AutoPESystem/AutoPAC/README.md

# AutoPAC
This repository will contain the relevant firmware and hardware for an automated PAC (Pump Assisted Clamping) Device.
