AutoPESystem/AutoPAC/Hardware/PCB/README.md

# PCB
This is a KiCAD PCB project that contains the hardware implementation required for the AutoPAC device.

This includes a vacuum sensor, positive pressure sensor, circuitry to drive 2 brushed motors, circuitry to control multiple solenoid relays, and an LCD interface over SPI.
