AutoPESystem/AutoPAC/Hardware/PCB/buck_reference_layout.png

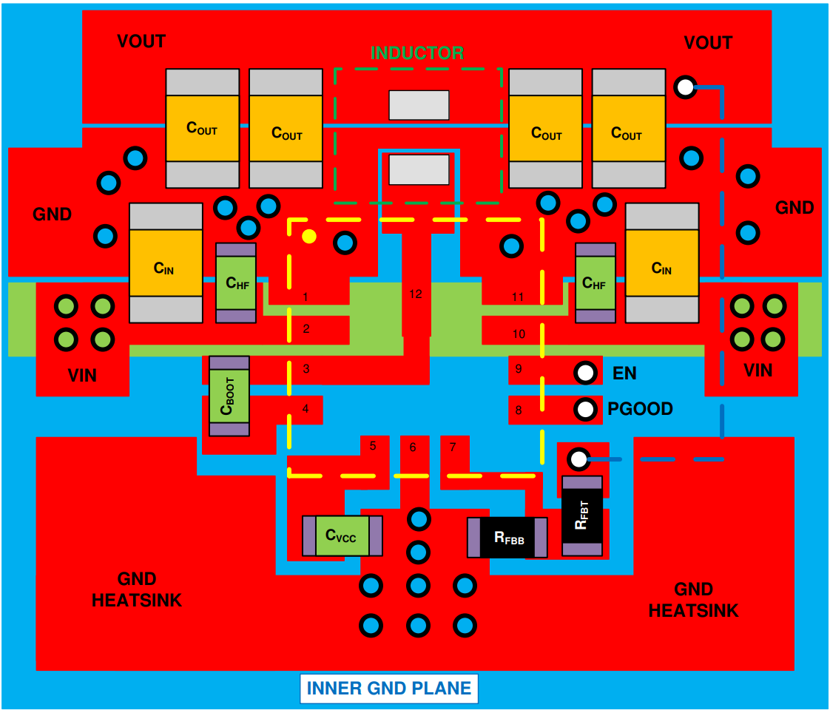
Hardware/PCB/buck_reference_layout.png
