AutoPESystem/AutoPAC/Hardware/PCB/lcd_reference_schematic.png

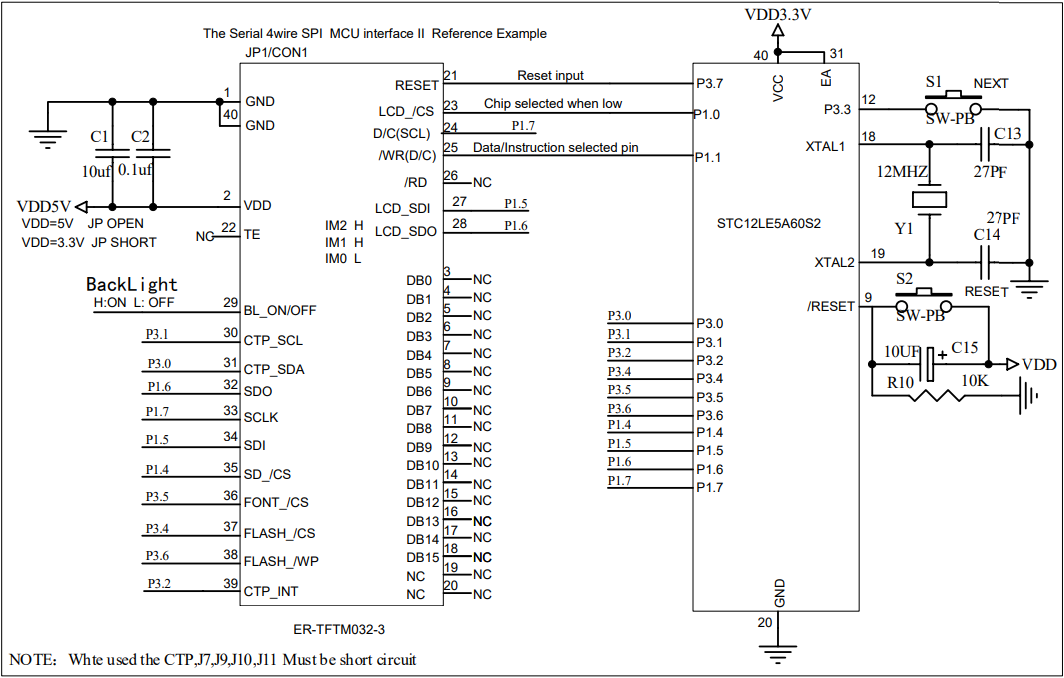
Hardware/PCB/lcd_reference_schematic.png
