AutoPESystem/AutoPAC/Hardware/PCB/suggested_stackup.png

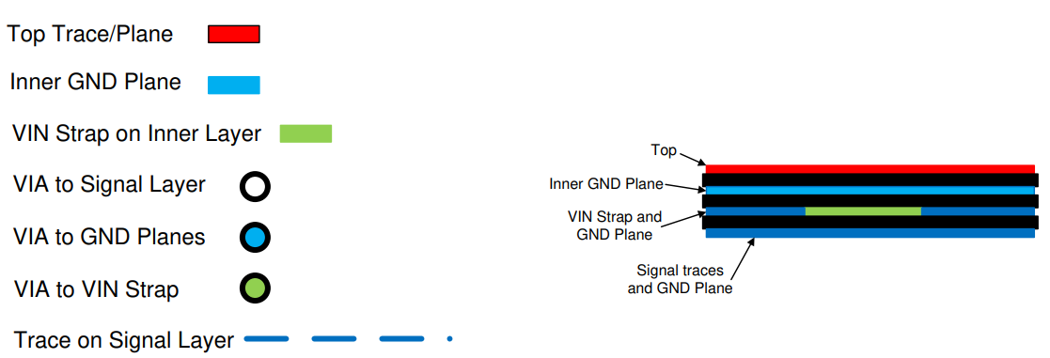
Hardware/PCB/suggested_stackup.png
