AutoPESystem/AutoPAC/Hardware/PCB/Vendor_3D_Models/MPX5500DP.stp

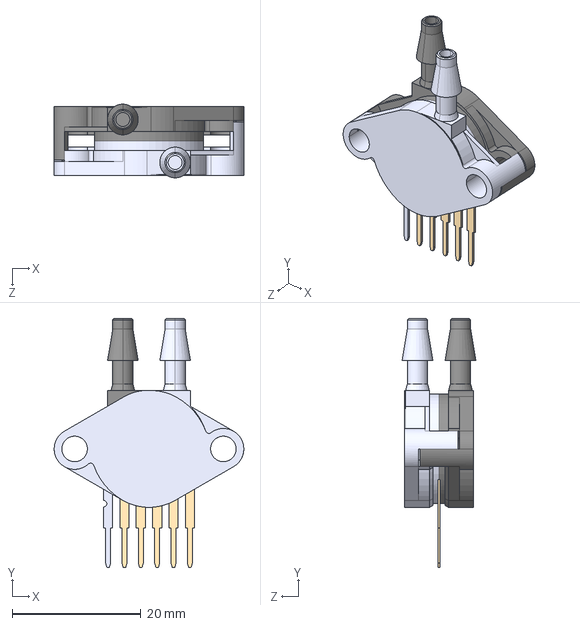
[picture p4: CAD file, 2025-03-04]
Hardware/PCB/Vendor_3D_Models/MPX5500DP.stp
29.5 x 38.7 x 11.5 mm
