AutoPESystem/AutoPAC/Hardware/PCB/Vendor_3D_Models/DTT0008A.stp

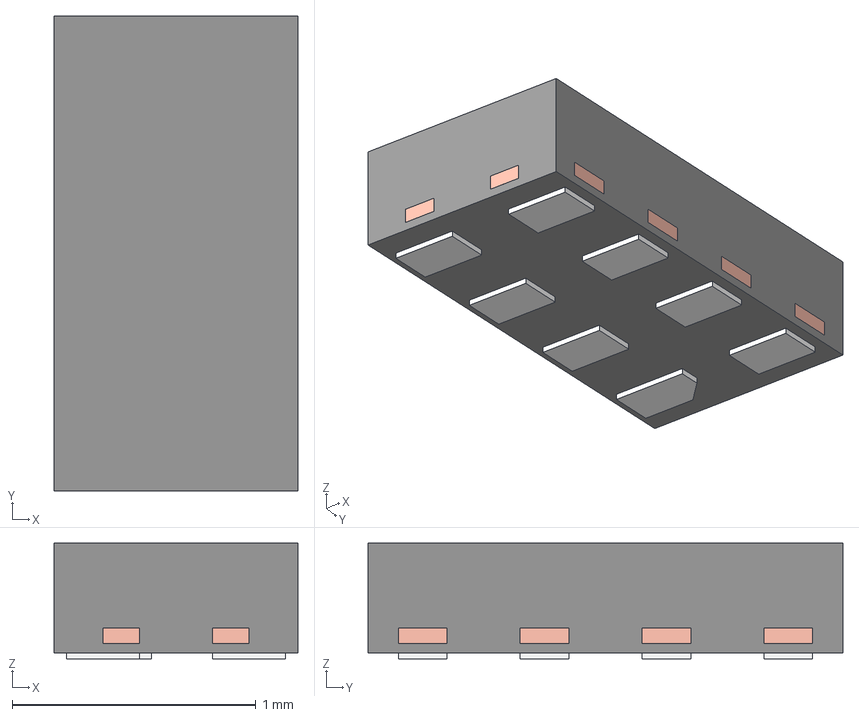
[picture p5: CAD file, 2025-03-02]
Hardware/PCB/Vendor_3D_Models/DTT0008A.stp
1.00 x 1.95 x 0.475 mm
BODY-SON
FRAME-DTT0008A
PIN1-ID
