AutoPESystem/AutoPAC/Hardware/PCB/Vendor_3D_Models/XSON8_SOT833-1_NEX.step

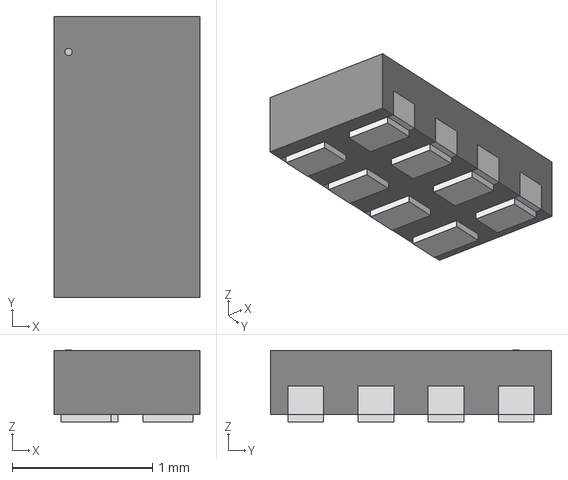
[picture p6: CAD file, 2025-03-02]
Hardware/PCB/Vendor_3D_Models/XSON8_SOT833-1_NEX.step
1.04 x 2.01 x 0.511 mm
