AutoPESystem/AutoPAC/Hardware/PCB/Vendor_3D_Models/TPSM84338RCJR.stp

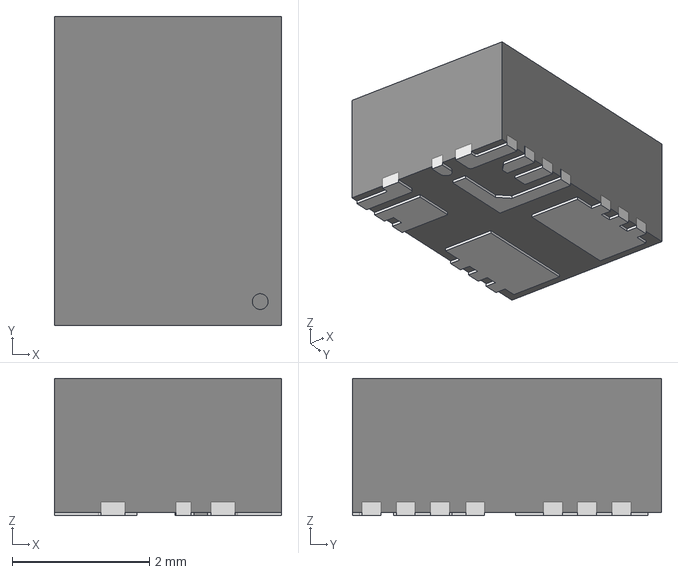
[picture p7: CAD file, 2025-03-02]
Hardware/PCB/Vendor_3D_Models/TPSM84338RCJR.stp
3.30 x 4.50 x 2.00 mm
