AutoPESystem/AutoPAC/Hardware/PCB/Vendor_3D_Models/SRN8040-3R3Y.stp

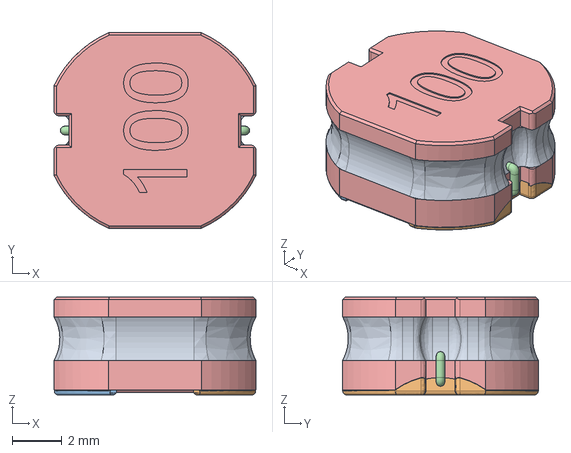
[picture p8: CAD file, 2025-03-02]
Hardware/PCB/Vendor_3D_Models/SRN8040-3R3Y.stp
8.15 x 7.90 x 3.95 mm
