AutoPESystem/AutoPAC/Hardware/PCB/Vendor_3D_Models/PHX_16pin_1985292.stp

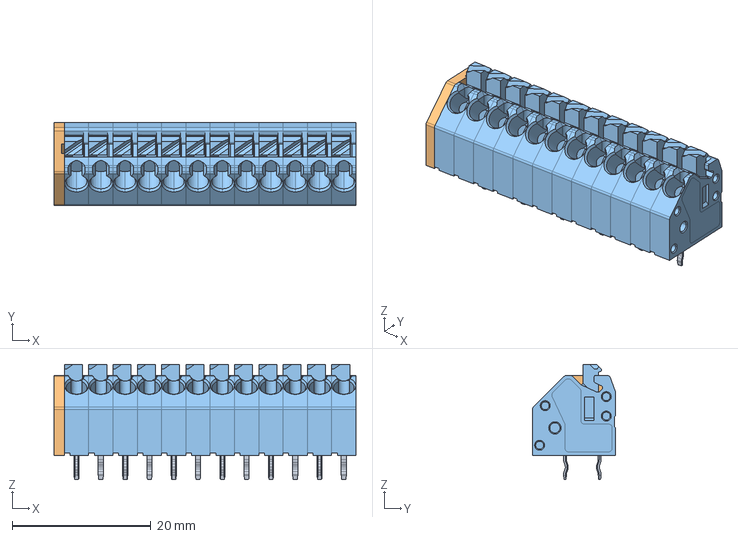
[picture p9: CAD file, 2025-03-02]
Hardware/PCB/Vendor_3D_Models/PHX_16pin_1985292.stp
43.5 x 12.0 x 16.6 mm
