AutoPESystem/AutoPAC/Hardware/PCB/Vendor_3D_Models/LSF0102DQER.step

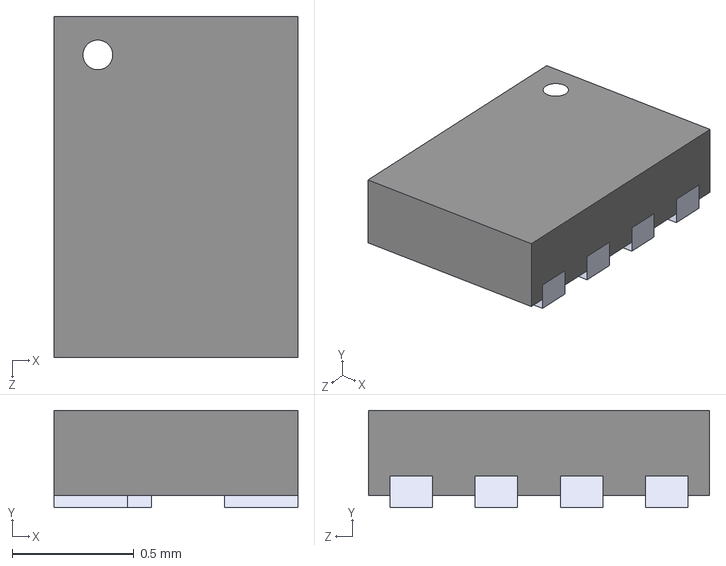
[picture p10: CAD file, 2025-03-02]
Hardware/PCB/Vendor_3D_Models/LSF0102DQER.step
1.00 x 0.4 x 1.40 mm
