AutoPESystem/AutoPAC/Hardware/PCB/Vendor_3D_Models/PJ-102A.step

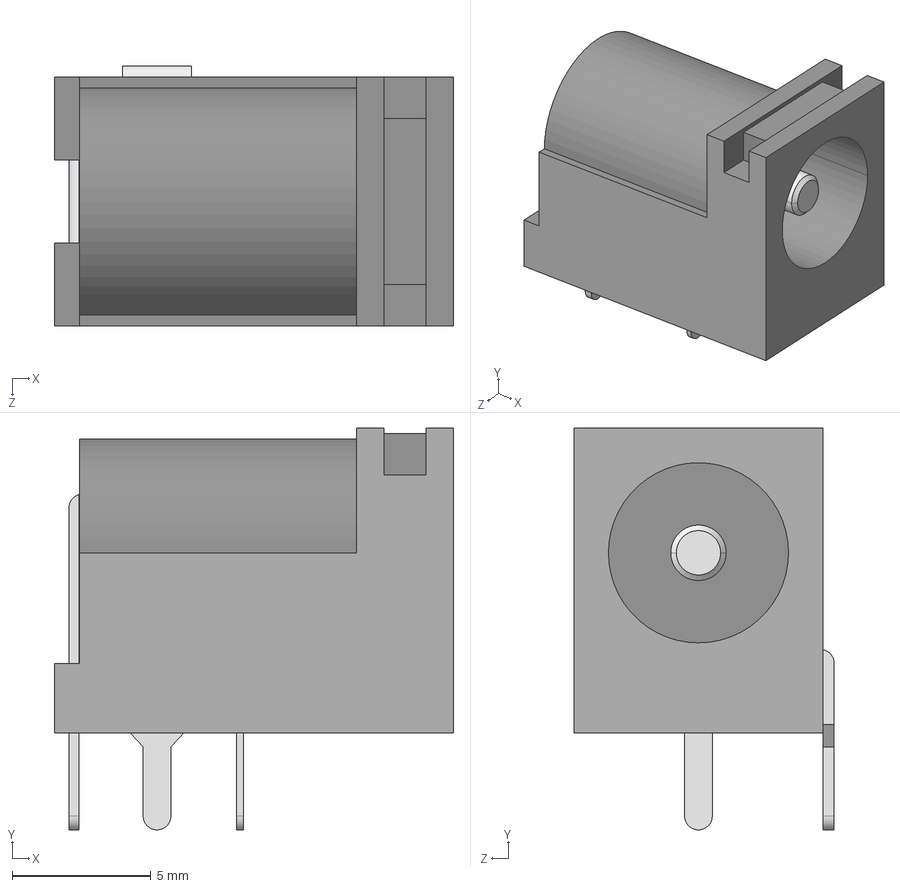
[picture p11: CAD file, 2025-02-24]
Hardware/PCB/Vendor_3D_Models/PJ-102A.step
14.4 x 14.5 x 9.40 mm
