AutoPESystem/AutoPAC/Hardware/PCB/Vendor_3D_Models/54-00127.step

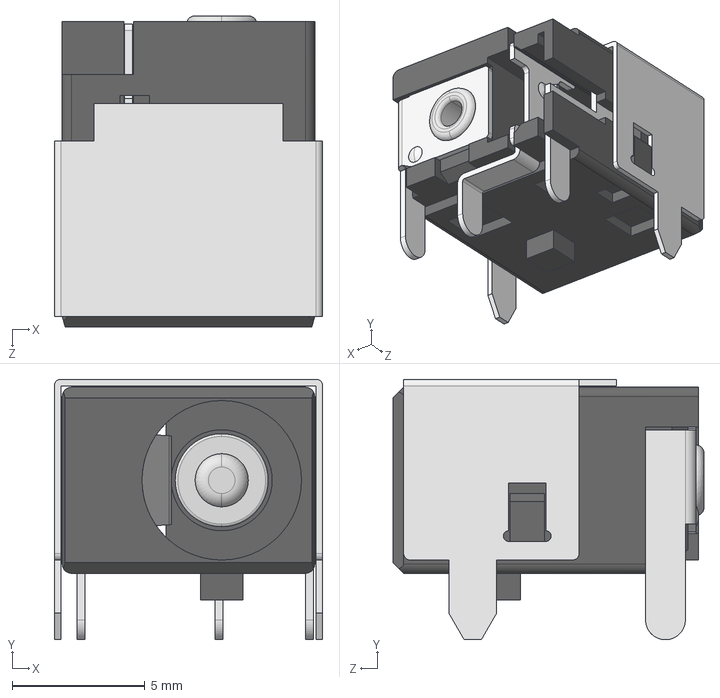
[picture p12: CAD file, 2025-02-24]
Hardware/PCB/Vendor_3D_Models/54-00127.step
10.1 x 9.80 x 11.7 mm
