AutoPESystem/AutoPAC/Hardware/PCB/Vendor_3D_Models/RNX0012A.stp

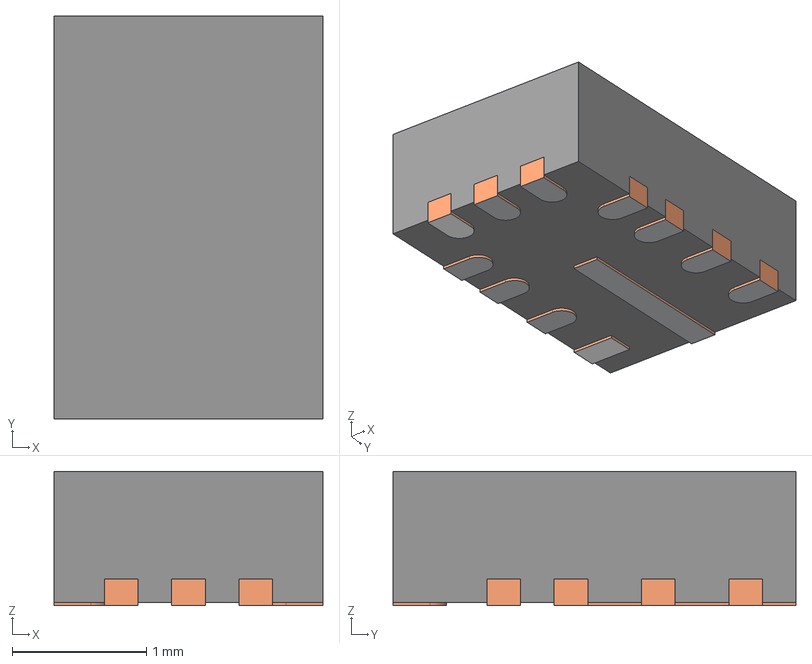
[picture p13: CAD file, 2025-02-24]
Hardware/PCB/Vendor_3D_Models/RNX0012A.stp
2.00 x 3.00 x 1.00 mm
FRAME-RNX0012A
BODY-QFN
PIN1-ID
