AutoPESystem/AutoPAC/Hardware/PCB/Vendor_3D_Models/FFC3B07-40-T.step

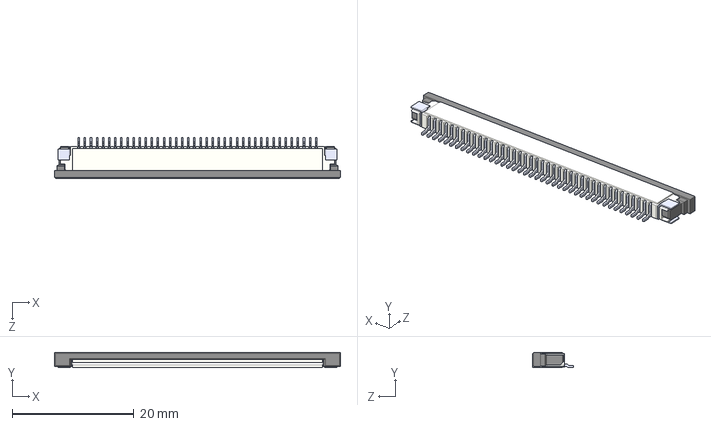
[picture p14: CAD file, 2025-02-21]
Hardware/PCB/Vendor_3D_Models/FFC3B07-40-T.step
47.0 x 2.50 x 6.75 mm
FFC3B07-xxxx_40
pin^FFC3B07-xxxx ass x 40
