AutoPESystem/AutoPAC/Hardware/PCB/Vendor_3D_Models/PTS647SN50SMTR2LFS.stp

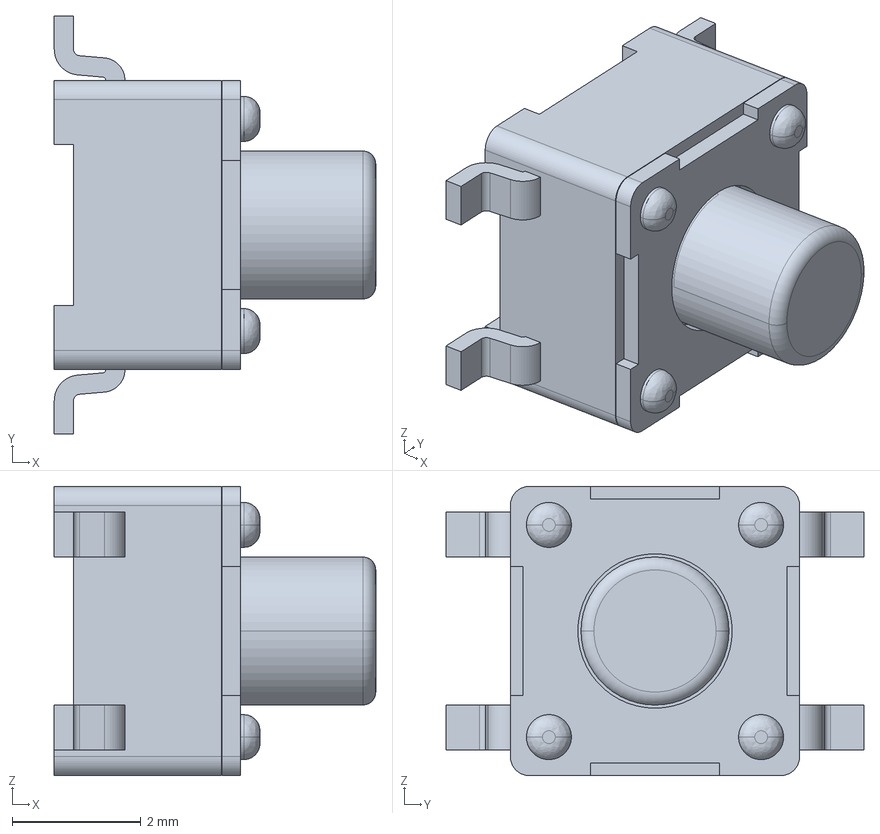
[picture p15: CAD file, 2025-02-21]
Hardware/PCB/Vendor_3D_Models/PTS647SN50SMTR2LFS.stp
5.00 x 6.50 x 4.50 mm
