AutoPESystem/AutoPAC/Hardware/PCB/Vendor_3D_Models/112C-TBAR-R02 v1.step

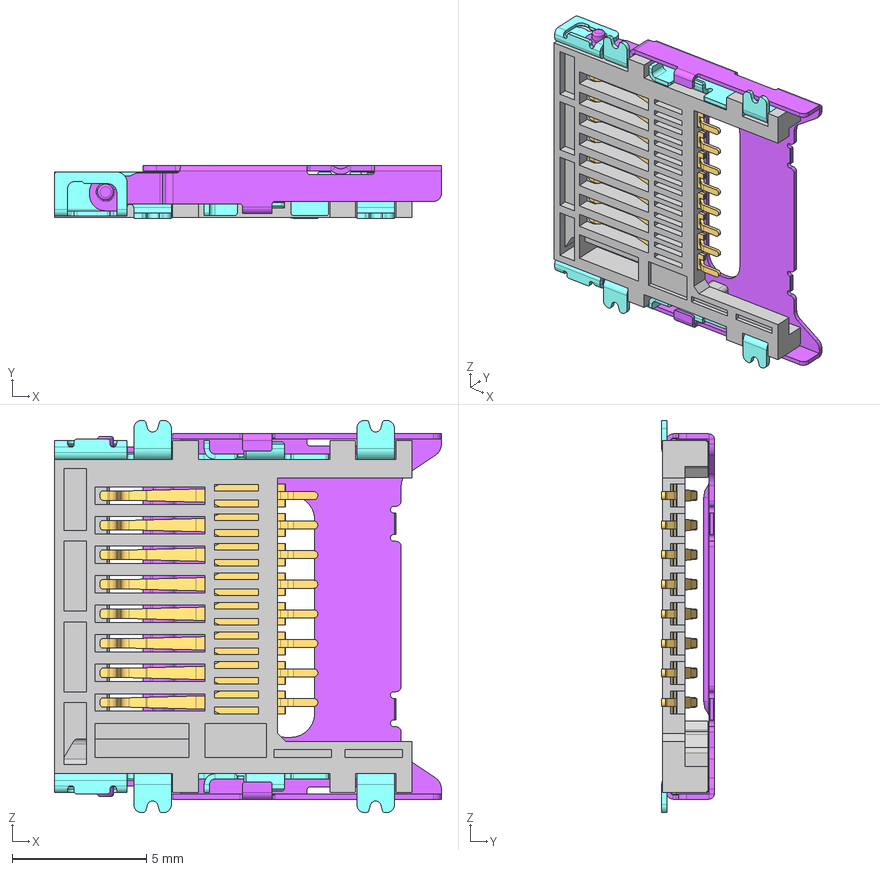
[picture p16: CAD file, 2025-02-21]
Hardware/PCB/Vendor_3D_Models/112C-TBAR-R02 v1.step
14.4 x 1.96 x 14.6 mm
