AutoPESystem/AutoPAC/Hardware/PCB/Vendor_3D_Models/c-1-2834011-2-2-3d.stp

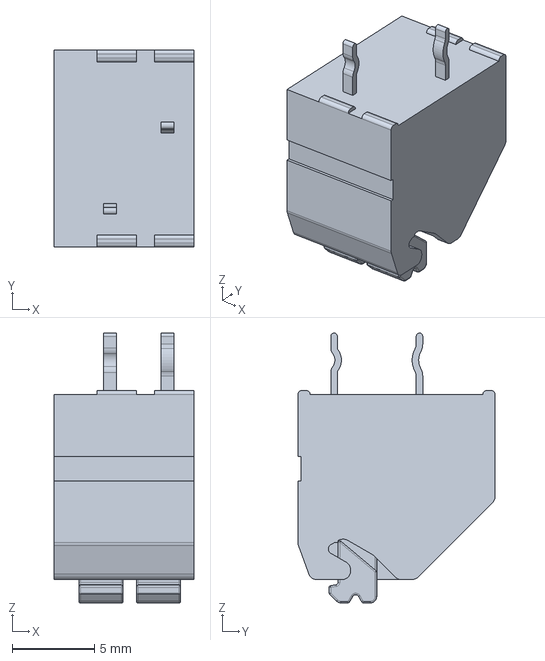
[picture p17: CAD file, 2025-02-21]
Hardware/PCB/Vendor_3D_Models/c-1-2834011-2-2-3d.stp
8.50 x 12.0 x 16.4 mm
