AutoPESystem/AutoPAC/Hardware/PCB/Vendor_3D_Models/1056.step

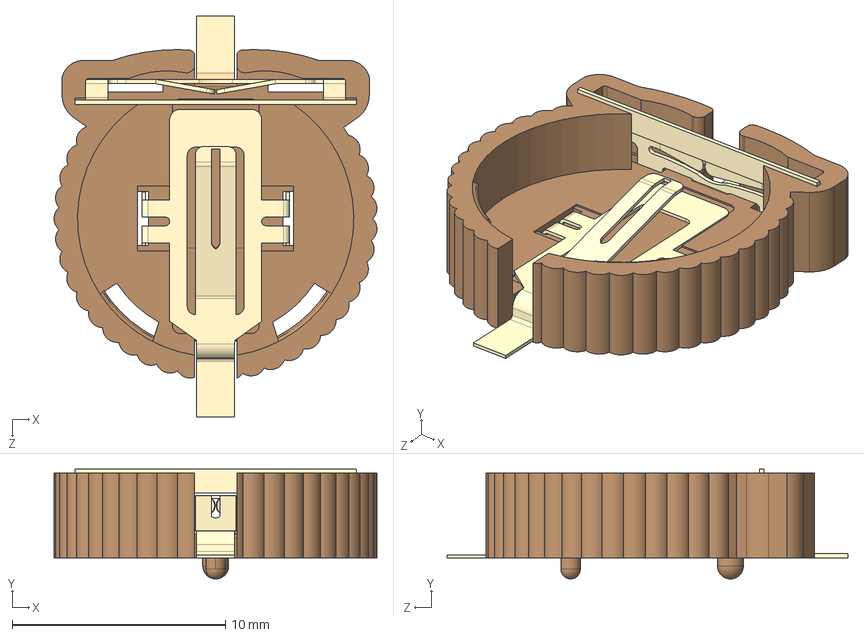
[picture p18: CAD file, 2025-02-21]
Hardware/PCB/Vendor_3D_Models/1056.step
15.1 x 5.16 x 18.8 mm
