AutoPESystem/AutoPAC/Hardware/PCB/Vendor_3D_Models/c-1-2834011-3-2-3d.stp

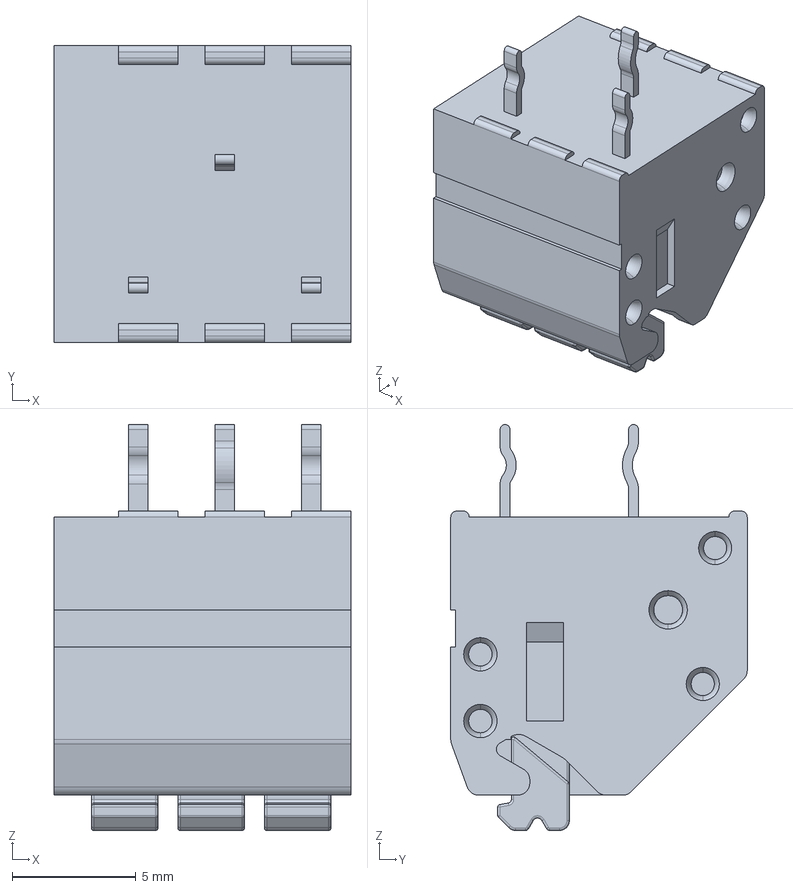
[picture p19: CAD file, 2025-02-21]
Hardware/PCB/Vendor_3D_Models/c-1-2834011-3-2-3d.stp
12.0 x 12.0 x 16.4 mm
