AutoPESystem/AutoPAC/Hardware/PCB/Vendor_3D_Models/ESP32-S3-WROOM-1U-N16R8.step

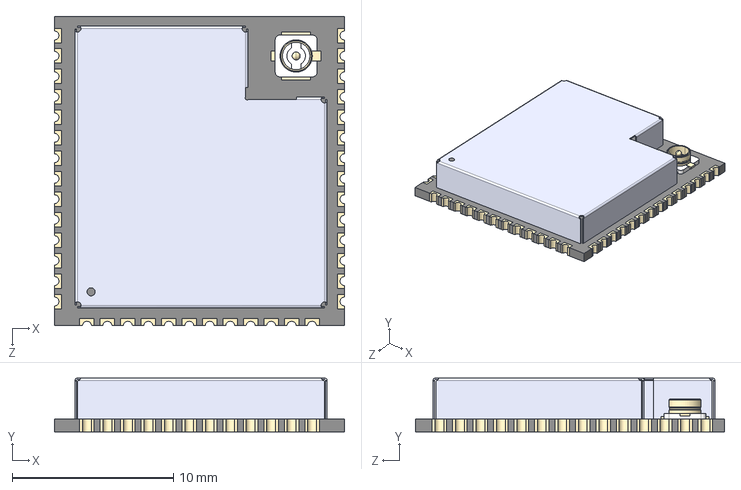
[picture p20: CAD file, 2025-02-21]
Hardware/PCB/Vendor_3D_Models/ESP32-S3-WROOM-1U-N16R8.step
18.0 x 3.35 x 19.2 mm
