AutoPESystem/AutoPAC/Hardware/PCB/Vendor_3D_Models/SX1509BIULTRT.step

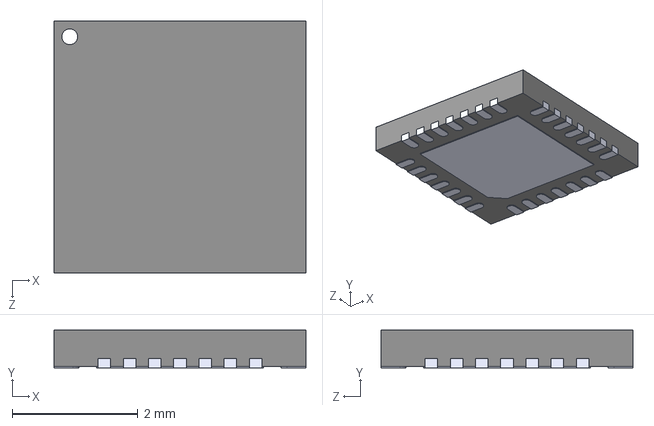
[picture p21: CAD file, 2025-02-21]
Hardware/PCB/Vendor_3D_Models/SX1509BIULTRT.step
4.00 x 0.6 x 4.00 mm
