AutoPESystem/AutoPAC/Hardware/PCB/Vendor_3D_Models/QFN20_4x4MC_MCH.step

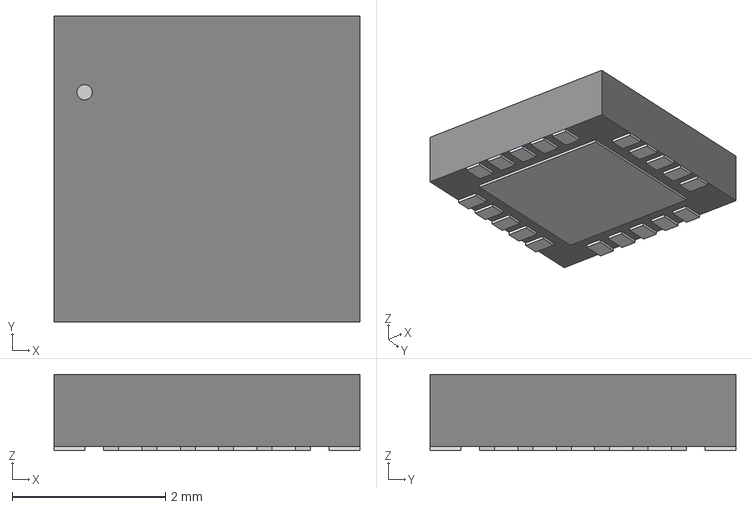
[picture p22: CAD file, 2025-02-21]
Hardware/PCB/Vendor_3D_Models/QFN20_4x4MC_MCH.step
3.99 x 3.99 x 0.993 mm
