AutoPESystem/AutoPAC/Hardware/PCB/Vendor_3D_Models/USB3160-XX-XXXX-X-X_REVA.step

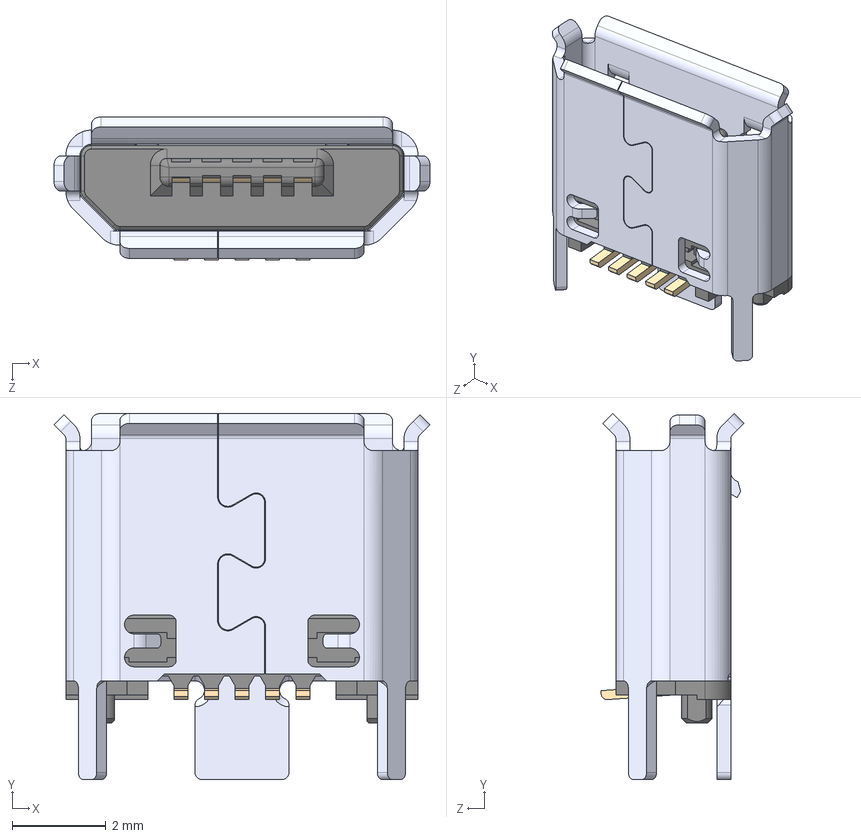
[picture p23: CAD file, 2025-02-21]
Hardware/PCB/Vendor_3D_Models/USB3160-XX-XXXX-X-X_REVA.step
8.00 x 7.79 x 3.04 mm
Housing.step
shell_With Entry face,shell stake =1.60mm.step
