AutoPESystem/AutoPAC/Hardware/PCB/Vendor_3D_Models/BU2032SM-BT-GTR.step

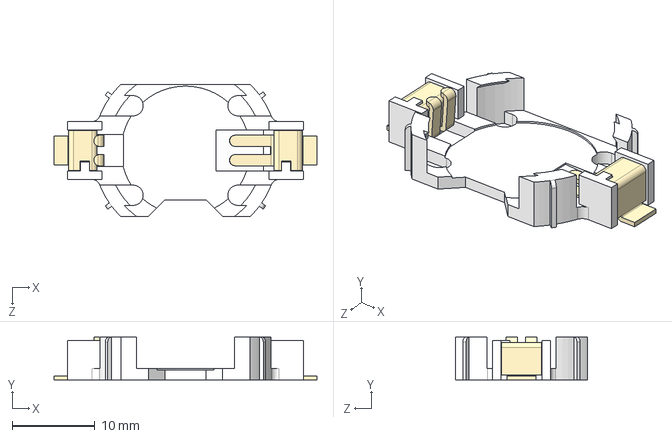
[picture p24: CAD file, 2025-02-21]
Hardware/PCB/Vendor_3D_Models/BU2032SM-BT-GTR.step
31.9 x 5.20 x 16.0 mm
