AutoPESystem/AutoPAC/Hardware/PCB/Vendor_3D_Models/6120XX21621_61201021621.step

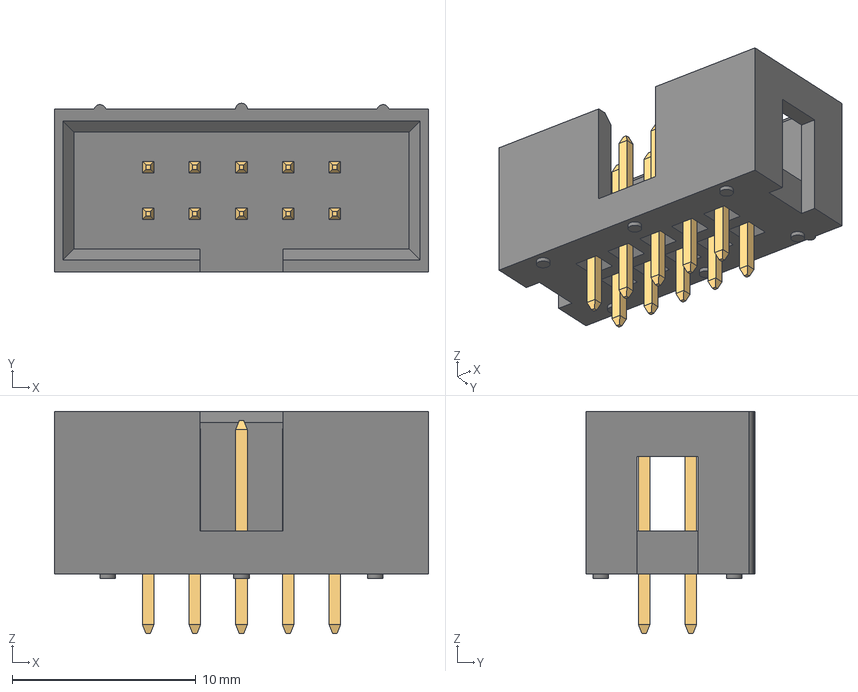
[picture p25: CAD file, 2025-02-21]
Hardware/PCB/Vendor_3D_Models/6120XX21621_61201021621.step
20.4 x 9.18 x 12.1 mm
6120xx21621_PIN x 10
