AutoPESystem/AutoPAC/Hardware/PCB/Vendor_3D_Models/PEC11R-4220K-S0024.STEP

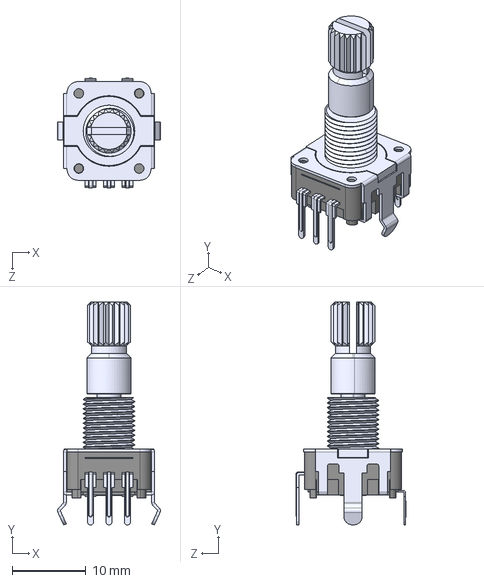
[picture p27: CAD file, 2025-02-21]
Hardware/PCB/Vendor_3D_Models/PEC11R-4220K-S0024.STEP
14.0 x 30.3 x 14.9 mm
