AutoPESystem/AutoPAC/Hardware/PCB/Vendor_3D_Models/MPXV6115VC6U.stp

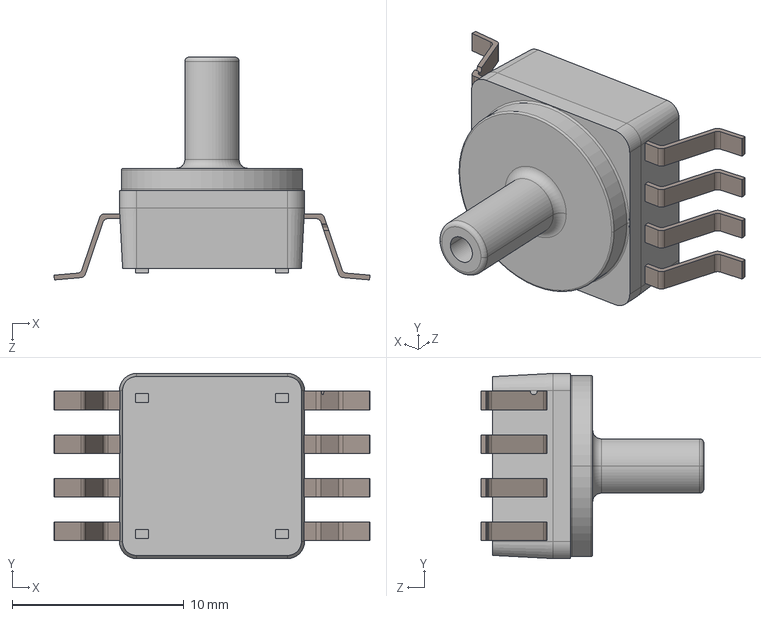
[picture p28: CAD file, 2025-02-21]
Hardware/PCB/Vendor_3D_Models/MPXV6115VC6U.stp
18.4 x 10.8 x 13.0 mm
