AutoPESystem/AutoPAC/Hardware/PCB/Vendor_3D_Models/MPX5100GP.stp

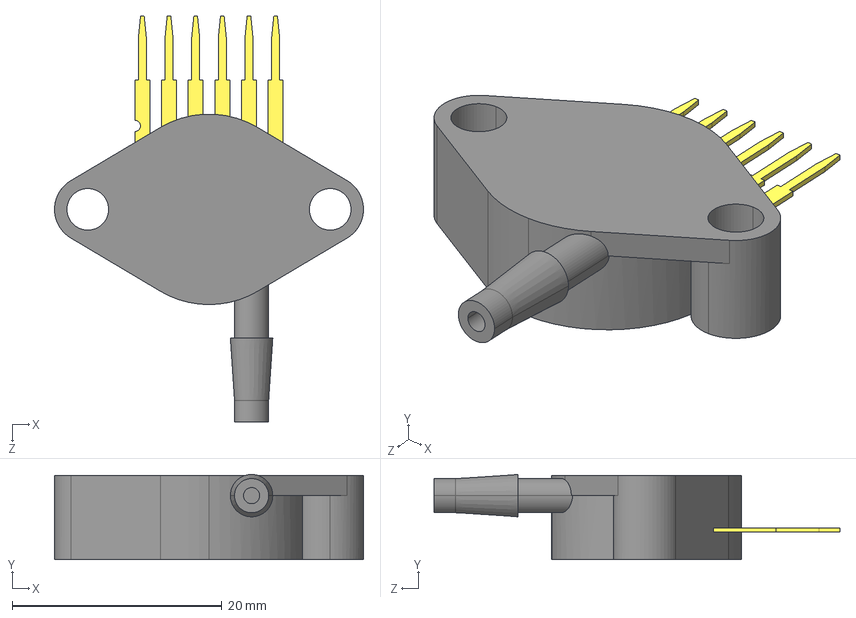
[picture p29: CAD file, 2025-02-21]
Hardware/PCB/Vendor_3D_Models/MPX5100GP.stp
29.5 x 8.12 x 38.7 mm
top
pins
