AutoPESystem/AutoPAC/Hardware/PCB/Vendor_3D_Models/ADS1219IPWR.step

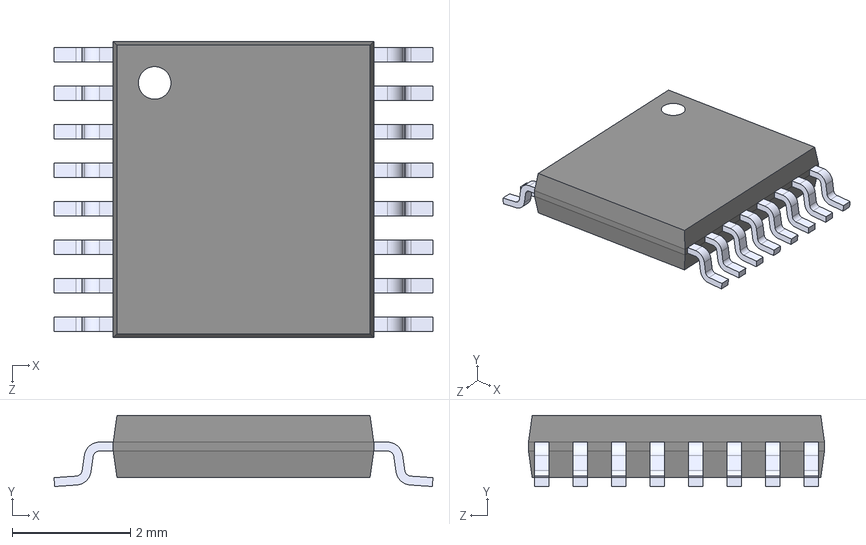
[picture p30: CAD file, 2025-02-21]
Hardware/PCB/Vendor_3D_Models/ADS1219IPWR.step
6.40 x 1.20 x 5.00 mm
