AutoPESystem/AutoPAC/Hardware/PCB/Vendor_3D_Models/DRV8243HQRXYRQ1.stp

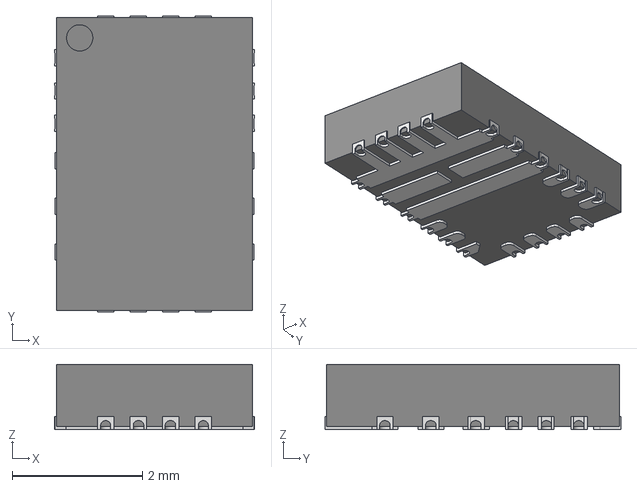
[picture p31: CAD file, 2025-02-21]
Hardware/PCB/Vendor_3D_Models/DRV8243HQRXYRQ1.stp
3.07 x 4.54 x 1.00 mm
