AutoPESystem/AutoPAC/(list of files, cad)

Other CAD files:
Hardware/PCB/Vendor_3D_Models/1984963.stp
Hardware/PCB/Vendor_3D_Models/1985195.stp
Hardware/PCB/Vendor_3D_Models/1985205.step
Hardware/PCB/Vendor_3D_Models/1985218.step
Hardware/PCB/Vendor_3D_Models/473092651.stp
Hardware/PCB/Vendor_3D_Models/541324062.stp
