AutoPESystem/AutoPAC/Hardware/PCB/PCB.kicad_pcb

## KiCad design Hardware/PCB/PCB.kicad_pcb (2025-03-04)

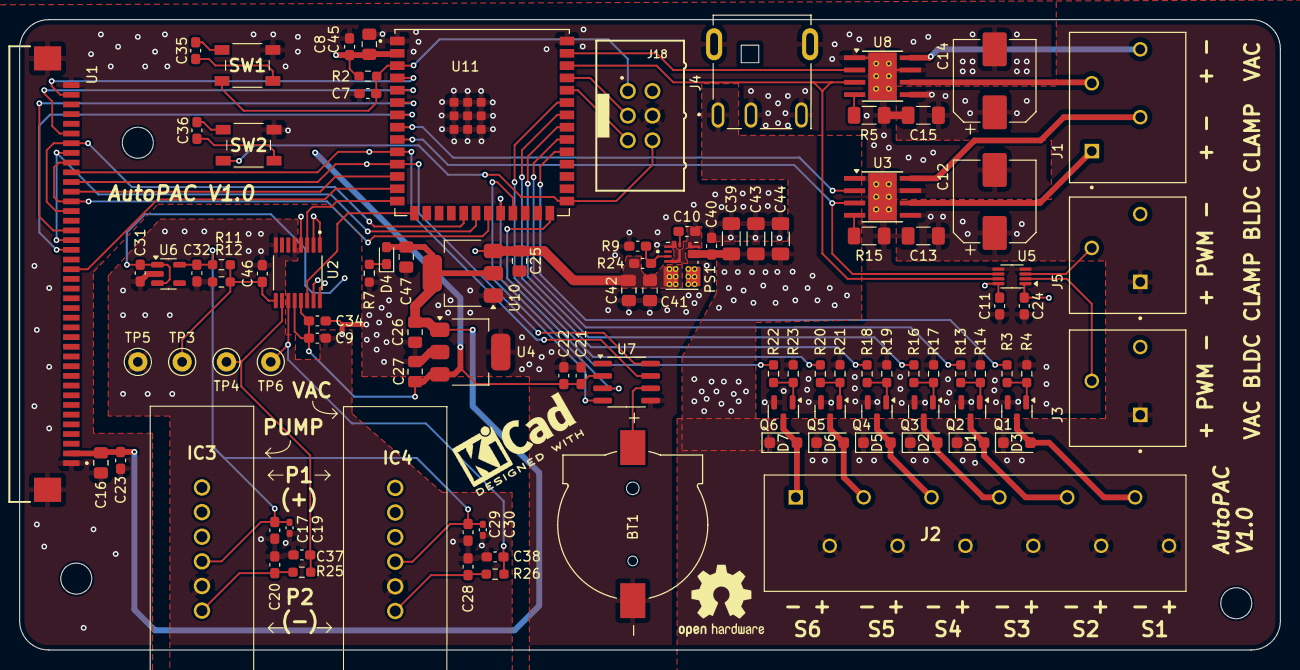
[picture p32: board PCB.kicad_pcb from above]

Board: 4 copper layers, 130.0 x 65.0 mm, 104 parts (0 on the bottom side), 69 nets.

Parts:
BT1: 1056; BAT_1056
C7: 1u; C_0603_1608Metric_Pad1.08x0.95mm_HandSolder
C8, C9, C10, C11, C24, C34, C35, C36, C46: 0.1u; C_0603_1608Metric_Pad1.08x0.95mm_HandSolder
C12, C14: 22uF; CP_Elec_8x10
C13, C15: 0.1uF; C_1206_3216Metric_Pad1.33x1.80mm_HandSolder
C16, C25, C26, C27: 10u; C_0805_2012Metric_Pad1.18x1.45mm_HandSolder
C17, C21, C29, C31, C32: 1uF; C_0603_1608Metric_Pad1.08x0.95mm_HandSolder
C19, C30: 0.01uF; C_0402_1005Metric_Pad0.74x0.62mm_HandSolder
C20, C28: 470pF; C_0603_1608Metric_Pad1.08x0.95mm_HandSolder
C22, C23, C40: 0.1uF; C_0603_1608Metric_Pad1.08x0.95mm_HandSolder
C37, C38: 0.33uF; C_0603_1608Metric_Pad1.08x0.95mm_HandSolder
C39, C43, C44: 10uF; C_1206_3216Metric_Pad1.33x1.80mm_HandSolder
C41, C42, C45, C47: 22uF; C_0805_2012Metric_Pad1.18x1.45mm_HandSolder
D1, D2, D3, D5, D6, D7: SMD110PL-TP; D_SOD-123F
D4: LED; LED_0603_1608Metric_Pad1.05x0.95mm_HandSolder
H1, H3, H4: MountingHole; MountingHole_3.2mm_M3
IC3, IC4: MPX5500DP
J1: DC Motor Terminal; TE_1985218
J2: Solenoid Terminal; PHX_16PIN_1985292
J3: Brushless Vac Motor; TE_1985205
J4: 54-00127; TENSILITY_54-00127
J5: Brushless Pump Motor; TE_1985205
J18: Programmer; 61200621621
NT1: NetTie_2; NetTie-2_SMD_Pad0.5mm
PS1: TPSM84338RCJR; CONV_TPSM84338RCJR
Q1, Q2, Q3, Q4, Q5, Q6: MMBT2222A; SOT-23
R2, R4, R14, R17, R19, R21, R23: 10k; R_0603_1608Metric_Pad0.98x0.95mm_HandSolder
R3, R7, R13, R16, R18, R20, R22: 470; R_0603_1608Metric_Pad0.98x0.95mm_HandSolder
R5, R15: 18k; R_1206_3216Metric_Pad1.30x1.75mm_HandSolder
R9: 10k; C_0603_1608Metric_Pad1.08x0.95mm_HandSolder
R11: 300; R_0603_1608Metric_Pad0.98x0.95mm_HandSolder
R12: 4.7k; R_0603_1608Metric_Pad0.98x0.95mm_HandSolder
R24: 82k; C_0603_1608Metric_Pad1.08x0.95mm_HandSolder
R25, R26: 750; R_0603_1608Metric_Pad0.98x0.95mm_HandSolder
SW1, SW2: PTS647SN50SMTR2LFS
TP3, TP4, TP5, TP6: TestPoint_Probe; TestPoint_Keystone_5000-5004_Miniature
U1: ER-TFTM032-3; GCT_FFC3B07-40-T
U2: ADS1219IPWR; SOP65P640X120-16N
U3, U8: DRV8871DDA; Texas_HTSOP-8-1EP_3.9x4.9mm_P1.27mm_EP2.95x4.9mm_Mask2.4x3.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
U4: AP7361C-33E; SOT-223-3_TabPin2
U5: 74LVC2T45DC; VSSOP-8_2.3x2mm_P0.5mm
U6: TPS7A2050PDBVR; SOT-23-5
U7: DS3232M; SOIC-8_3.9x4.9mm_P1.27mm
U10: AZ1117-5.0; SOT-223-3_TabPin2
U11: ESP32-S3-WROOM-1U-N16R8; XCVR_ESP32-S3-WROOM-1U-N16R8

Connections:
+3.3V: C8.2, C9.2, C11.1, C21.1, C22.2, C27.1, C34.2, C45.2, R2.1, U2.12 (AVDD), U2.13 (DVDD), U4.3 (VO), U5.8 (VCCB), U7.2 (VCC), U11.2 (3V3)
+4.7V: C46.1, R11.2, R12.1, TP3.1, U2.9 (REFP)
+5.5V: C25.1, C31.2, C41.1, C42.1, PS1.4 (VOUT), R24.1, U6.1 (IN), U6.3 (EN), U10.3 (VI)
+5V: C16.2, C23.2, C24.1, C26.1, C47.1, D4.2 (A), U1.2 (VDD), U4.1 (VI), U5.1 (VCCA), U10.2 (VO)
+5VA: C17.1, C19.1, C29.1, C30.1, C32.2, IC3.3 (VCC), IC4.3 (VCC), R11.1, U6.5 (OUT)
+24V: C12.1, C13.1, C14.1, C15.1, C39.1, C40.2, C43.1, C44.1, D1.1 (K), D2.1 (K), D3.1 (K), D5.1 (K), D6.1 (K), D7.1 (K), J2.2, J2.4, J2.6, J2.8, J2.10, J2.12, J3.1, J4.A, J5.1, PS1.6 (VIN), U3.5 (VM), U8.5 (VM)
/ADC-DRDY: U2.14 (~DRDY), U11.15 (IO3)
/ADC-RESET: U2.3 (~RESET), U11.14 (IO20)
/CTP-INT: U1.39 (CTP_INT), U11.4 (IO4)
/DISP-BACKLIGHT: U1.29 (BL_ON/OFF), U11.12 (IO8)
/DISP-CS: U1.23 (LCD_CS), U11.7 (IO7)
/DISP-DC: U1.25 (/WR(D/C)), U11.6 (IO6)
/DISP-RESET: U1.21 (RESET), U11.13 (IO19)
/ESP32-S3/BOOT: J18.6, SW2.1, U11.27 (IO0)
/ESP32-S3/EN: C7.2, J18.1, R2.2, SW1.1, U11.3 (EN)
/ESP32-S3/RX: J18.5, U11.36 (RXD0)
/ESP32-S3/TX: J18.3, U11.37 (TXD0)
/I2C-SCL: U1.30 (CTP_SCL), U2.16 (SCL), U7.8 (SCL), U11.11 (IO18)
/I2C-SDA: U1.31 (CTP_SDA), U2.15 (SDA), U7.7 (SDA), U11.10 (IO17)
/PUMP-IN1: U3.3 (IN1), U5.6 (2B), U11.9 (IO16)
/PUMP-IN2: U3.2 (IN2), U11.8 (IO15)
/RTC-INT: U7.3 (~INT/SQW), U11.22 (IO14)
/RTC-RESET: U7.4 (~RST), U11.23 (IO21)
/SOLENOID_1: R3.1, U11.31 (IO38)
/SOLENOID_2: R13.1, U11.32 (IO39)
/SOLENOID_3: R16.1, U11.33 (IO40)
/SOLENOID_4: R18.1, U11.34 (IO41)
/SOLENOID_5: R20.1, U11.35 (IO42)
/SOLENOID_6: R22.1, U11.26 (IO45)
/SPI-CLK: U1.24 (D/C(SCL)), U1.33 (SCLK), U11.20 (IO12)
/SPI-MISO: U1.28 (LCD_SDO), U1.32 (SDO), U11.21 (IO13)
/SPI-MOSI: U1.27 (LCD_SDI), U1.34 (SDI), U11.19 (IO11)
/VAC-IN1: U5.7 (1B), U8.3 (IN1), U11.38 (IO2)
/VAC-IN2: U8.2 (IN2), U11.39 (IO1)
/brushless_motor_pwm_driver/BRUSHLESS_PWM_1: J3.2, U5.2 (1A)
/brushless_motor_pwm_driver/BRUSHLESS_PWM_2: J5.2, U5.3 (2A)
/motor_driver1/MOTOR-OUT-1: J1.1, U3.6 (OUT1)
/motor_driver1/MOTOR-OUT-2: J1.2, U3.8 (OUT2)
/motor_driver/MOTOR-OUT-1: J1.3, U8.6 (OUT1)
/motor_driver/MOTOR-OUT-2: J1.4, U8.8 (OUT2)
/relay_driver1/COIL-: D1.2 (A), J2.9, Q2.3 (C)
/relay_driver2/COIL-: D2.2 (A), J2.7, Q3.3 (C)
/relay_driver3/COIL-: D5.2 (A), J2.5, Q4.3 (C)
/relay_driver4/COIL-: D6.2 (A), J2.3, Q5.3 (C)
/relay_driver5/COIL-: D7.2 (A), J2.1, Q6.3 (C)
/relay_driver/COIL-: D3.2 (A), J2.11, Q1.3 (C)
/sensors/CLAMP_SENSOR: C37.2, R25.2, TP4.1, U2.10 (AIN1)
/sensors/VAC_SENSOR: C38.2, R26.2, TP6.1, U2.11 (AIN0)
/uSD-CS: U1.35 (SD_/CS), U11.5 (IO5)
GND: BT1.N, C7.1, C8.1, C10.2, C11.2, C12.2, C13.2, C14.2, C15.2, C16.1, C21.2, C22.1, C23.1, C24.2, C25.2, C26.2, C27.2, C34.1, C39.2, C40.1, C41.2, C42.2, C43.2, C44.2, C45.1, C47.2, J3.3, J4.B, J4.C, J4.SH1, J4.SH2, J5.3, J18.4, NT1.2, PS1.3 (GND), PS1.7 (MODE), PS1.9 (RT/SYNC), Q1.2 (E), Q2.2 (E), Q3.2 (E), Q4.2 (E), Q5.2 (E), Q6.2 (E), R4.2, R5.2, R7.2, R9.2, R14.2, R15.2, R17.2, R19.2, R21.2, R23.2, SW1.3, SW2.3, U1.1 (GND), U1.40 (GND), U1.S1, U1.S2, U2.1 (A0), U2.2 (A1), U2.4 (DGND), U3.1 (GND), U3.7 (GND), U3.9 (GND), U4.2 (GND), U5.4 (GND), U5.5 (DIR), U7.5 (GND), U8.1 (GND), U8.7 (GND), U8.9 (GND), U10.1 (GND), U11.1 (GND), U11.40 (GND__1), U11.41_1 (GND__2), U11.41_2 (GND__3), U11.41_3 (GND__4), U11.41_4 (GND__5), U11.41_5 (GND__6), U11.41_6 (GND__7), U11.41_7 (GND__8), U11.41_8 (GND__9), U11.41_9 (GND__10)
GNDA: C9.1, C17.2, C19.2, C20.1, C28.1, C29.2, C30.2, C31.1, C32.1, C37.1, C38.1, C46.2, IC3.2 (GROUND), IC4.2 (GROUND), NT1.1, R12.2, TP5.1, U2.5 (AGND), U2.8 (REFN), U6.2 (GND)
unnamed: C35.1, SW1.2
unnamed: C35.2, SW1.4
unnamed: C36.1, SW2.2
unnamed: C36.2, SW2.4
unnamed: D4.1 (K), R7.1
unnamed: C20.2, IC3.1 (VOUT), R25.1
unnamed: C28.2, IC4.1 (VOUT), R26.1
unnamed: PS1.2 (FB), R9.1, R24.2
unnamed: C10.1, PS1.8 (SS/PG)
unnamed: Q1.1 (B), R3.2, R4.1
unnamed: Q2.1 (B), R13.2, R14.1
unnamed: Q3.1 (B), R16.2, R17.1
unnamed: Q4.1 (B), R18.2, R19.1
unnamed: Q5.1 (B), R20.2, R21.1
unnamed: Q6.1 (B), R22.2, R23.1
unnamed: R15.1, U3.4 (ILIM)
unnamed: BT1.P, U7.6 (VBAT)
unnamed: R5.1, U8.4 (ILIM)
