AutoPESystem/AutoPAC/(commit log)

2025-02-21 added README to PCB
2025-02-21 added a lot of stuff, going to work on LCD + Touch next
    [1056.step, 112C-TBAR-R02 v1.step, 1984963.stp, 1985195.stp, 1985205.step, 473092651.stp, 541324062.stp, 6120XX21621_61200621621.step]
2025-02-21 added symbol for LCD, working on adding PWM output terminal for brushless pump motors
    [FFC3B07-40-T.step, PCB.kicad_sch, power.kicad_sch, relay_driver.kicad_sch, rtc.kicad_sch, serial_spi_lcd.kicad_sch]
2025-02-21 Added brushless DC support, fixed terminal blocks too
    [motor_driver.kicad_sch, power.kicad_sch, relay_driver.kicad_sch, rtc.kicad_sch, serial_spi_lcd.kicad_sch]
2025-02-24 switched to making buck converter to save costs and space, and to allow for LDO after 5.5V for better stability
    [54-00127.step, PCB.kicad_sch, PJ-102A.step, RNX0012A.stp, buck.kicad_sch, esp32.kicad_sch, motor_driver.kicad_sch, power.kicad_sch]
2025-02-24 swapped to be better precision resistors for feedback on buck and votlage reference for ADCs
    [PCB.kicad_sch, buck.kicad_sch, power.kicad_sch, sensors.kicad_sch]
2025-02-24 consolidated IO for LCD block, broke out hierarchial pins, need to start wiring everything up and then on to layout
    [PCB.kicad_sch, buck.kicad_sch, esp32.kicad_sch, ldos.kicad_sch, motor_driver.kicad_sch, relay_driver.kicad_sch, serial_spi_lcd.kicad_sch]
2025-03-02 overall design is pretty much done, starting layout and routing now
    [1985218.step, DTT0008A.stp, LSF0102DQER.step, PCB.kicad_pcb, PCB.kicad_sch, PHX_16pin_1985292.stp, SRN8040-3R3Y.stp, TPSM84338RCJR.stp]
2025-03-04 pcb layout and routing pretty much done, checking DRC
    [MPX5500DP.stp, PCB.kicad_pcb, PCB.kicad_sch, brushless_motor_pwm_driver.kicad_sch, esp32.kicad_sch, ldos.kicad_sch, serial_spi_lcd.kicad_sch]
2025-03-04 fixed BOM, added some silkscreen, getting quote now
    [PCB.kicad_pcb, brushless_motor_pwm_driver.kicad_sch, buck.kicad_sch, esp32.kicad_sch, ldos.kicad_sch, rtc.kicad_sch, sensors.kicad_sch, serial_spi_lcd.kicad_sch]
2025-03-04 kinda pricey, I should try to make a smaller version using LCSC parts for cheaper solution
    [PCB-B_Cu.gbl, PCB-B_Mask.gbs, PCB-B_Paste.gbp, PCB-B_Silkscreen.gbo, PCB-Edge_Cuts.gm1, PCB-F_Cu.gtl, PCB-F_Mask.gts, PCB-F_Paste.gtp]
